BryanPuckettGH/growthpulse-app/docs/GrowthPulse Wiring Diagram.pdf

# GrowthPulse Node - Wiring

Heltec WiFi LoRa 32 V3 (HTIT-WB32LAF). Drawn to match the labels printed on your board.

## 1. Where the pins are - TOP row, USB-C on the right

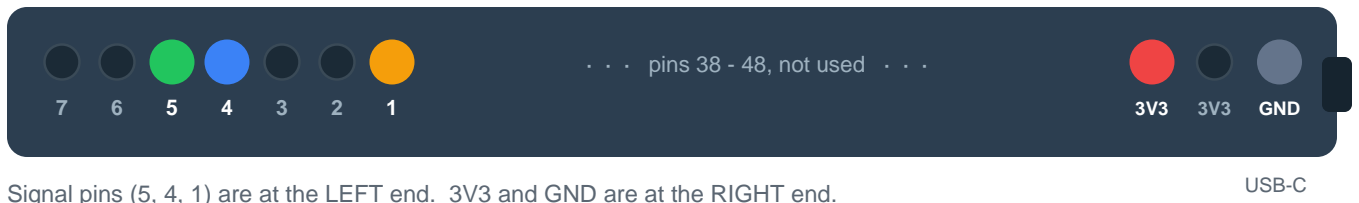
[picture p12: figure]
USB-C; · · · pins 38 - 48, not used · · ·; GND

Signal pins (5, 4, 1) are at the LEFT end. 3V3 and GND are at the RIGHT end.

2. Power the board: | USB-C, or the | 5V | and | GND | pins on the bottom row.

## 3. Connect each sensor (sensor pin -> board pin)

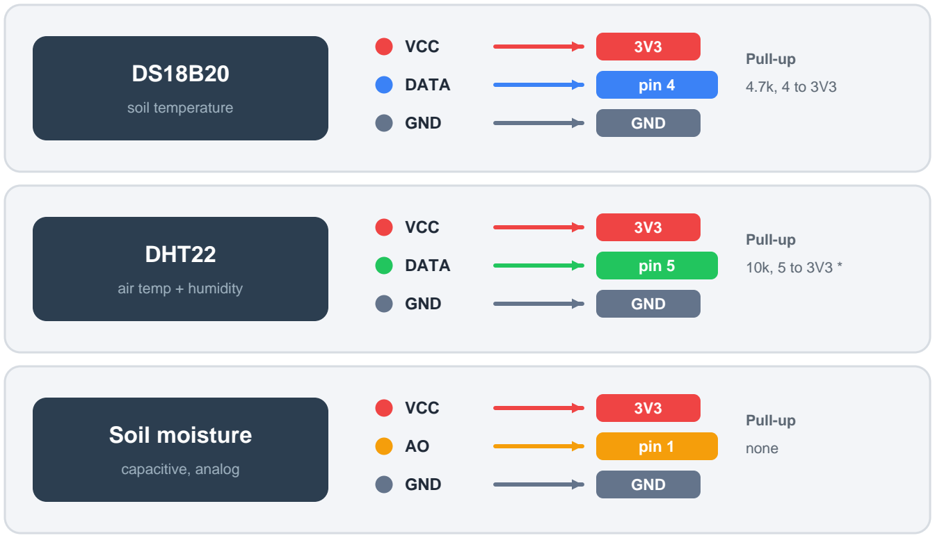
[picture p13: figure]
soil temperature; VCC; DATA; pin 4; GND; Pull-up; DHT22; air temp + humidity; pin 5; Soil moisture; capacitive, analog; pin 1; none

* the 3-pin DHT22 module already has its 10k resistor built in - just wire +, out, -.

Remember
All three sensors get VCC from 3V3 and GND from GND. Power sensors on 3V3 only - never 5V.
