BryanPuckettGH/growthpulse-app/CHANGELOG.md

# Changelog

All notable changes to GrowthPulse, the web app and the device firmware.

---

## Web App

### v2.26.0 - August 12, 2026
- LinkedIn is now reachable from the public site, which previously offered a visitor no way at all to make contact. The link sits under the signature in the welcome overlay, in The Project page header next to GitHub, and beside the commit-authorship line in the attribution section. All three read one `LINKEDIN_URL` constant in `WelcomeModal.jsx` and render nothing when it is empty, so the profile can never ship as a dead link.

### v2.25.0 - August 12, 2026
- The project video playlist is now embedded on The Project page: seven videos spanning the first concept pitch, the bench demos, and the final senior design presentation. Player is served from `youtube-nocookie.com` and lazy-loaded so it costs nothing until scrolled to, with a link out to the full playlist and a "Watch the build" button in the page header.
- The welcome overlay now opens on every load of the public site rather than once per browser session. It is the introduction to the project, so a refresh or a return visit should show it again; navigating between pages within the site still leaves it closed once dismissed.

### v2.24.0 - August 12, 2026
- The public site now introduces itself to the people who actually arrive on it. growthpulsecloud.com is linked from a resume, so a large share of first-time visitors are recruiters and engineers rather than customers, and the marketing copy alone never told them who built this or when. A welcome overlay (`WelcomeModal.jsx`) opens on arrival with a short note from the team lead, full Team 15 credits with each member's contribution, and two ways forward: browse the product site, or jump to the engineering write-up. Dismissal is remembered per browser session in `sessionStorage`, so moving between pages does not reopen it but a fresh visit does. It can be reopened any time from the footer.
- New "The Project" page (`ProjectPage.jsx`), a sixth entry in the marketing nav: the build by the numbers, the system layer by layer, a timeline, per-person attribution, and the six debugging problems worth talking about (the NE555 browning out on the 3.3V rail, the GPIO1 conflict with onboard battery sense, fitting flow and status into the 11-byte US915 DR0 payload, provisioning that minted orphan DevEUIs, Losant rejecting an entire state report over one undefined attribute, and `resets_join_nonces` being written to the Network Server instead of the Join Server).
- Marketing site caught up with the product. Everything shipped since v2.19.0 was invisible to a visitor: the site still sold a monitoring-only device with "4 sensors per node" and no mention anywhere of irrigation, the flow meter, water cost, leak detection, Google Home, or the iOS app. New "Watering" page covering timed runs, live flow confirmation, the self-closing dry-run cutoff, the leak alarm, meter-style cost accounting, and rain delay. The hero, the stats row, the home feature cards, the Features grid, and the FAQ all now describe a system that acts on what it measures instead of only reporting it.
- Footer gains a fourth column linking the project page, the team lead's note, and the GitHub repository, and a Watering link under Product.
- `.proj__numbers` grid children carry `min-width: 0` so the stats row cannot force horizontal overflow on a narrow window.

### v2.23.0 - July 7, 2026
- Water metering, from the new YF-S201 flow sensor (firmware 5.1). The Live view gains a Water card: live flow rate while watering, water used today / this week / this month with dollar costs, the current/last run's volume, and the lifetime total. Costs use a user-set rate in Settings ("$ per 1,000 gallons", straight off the utility bill), with a gallons/liters toggle that converts the rate when flipped.
- Smart watering warnings. If a watering run opens the valve and the sensor sees no water (empty reservoir, kinked line, dead pump), the node closes the valve itself and the app shows a "No water flow detected" banner; a `flowFault` alarm rule is on by default. A leak alarm trips when water flows for 30+ seconds while the valve is closed. Both are boolean fault alarms: the alarm card explains the condition instead of showing a threshold slider.
- The Watering card now shows live confirmation from the flow sensor during a run ("Flowing 1.9 L/min" or "Waiting for water to move...") so a dry run is visible the moment it happens.
- New `water-usage` function: usage per day computed meter-style by diffing the node's cumulative `waterTotalL` counter (MAX per bucket), which stays accurate across missed samples and handles counter resets. `device-state` passes the six new water fields through; `provision-device` defines them on new devices; `scripts/add-water-attributes.mjs` backfills devices provisioned before they existed (Losant drops state for undefined attributes, so run it once).
- The LoRaWAN uplink webhook now decodes both payload layouts by length: legacy 9-byte v1 and the new 11-byte v2 that carries flow, total, and the valve/fault/leak status bits (v2 drops the raw soil ADC to stay inside the US915 DR0 11-byte limit; moisture 0xFF now marks a disconnected probe).
- The device simulator publishes the water fields too, including a periodic simulated no-flow run, so the whole feature can be demoed without hardware.

### v2.22.2 - June 12, 2026
- Fixed `resets_join_nonces` never actually being set. It was being written to the Network Server, which rejects it as a forbidden field-mask path, so provisioning's attempt silently failed (and a new-device provision would have errored at that step). It is a Join Server setting; it now goes on the `js/` endpoint in both the create and reuse paths. With it set, a board joins LoRaWAN on the first try after a reflash instead of burning a minute of `-1116` DevNonce-catch-up retries.

### v2.22.1 - June 12, 2026
- Fixed the gateway QR scanner that sometimes would not open or would not scan. The scanner effect depended on its `onResult` callback, which the Devices view recreated on every render (and it re-renders every few seconds from the live-polling loop), so the camera was torn down and restarted constantly and never got a stable moment to decode. The effect now runs once on mount and reads the latest callback through a ref. Also added `autoPlay` to the video and a metadata-load play retry so frames flow reliably (notably on iOS Safari, where `play()` can be rejected outside the original tap).

### v2.22.0 - June 11, 2026
- Fixed the root cause of LoRaWAN data never reaching the app: Losant rejects an entire state report that includes an attribute the device doesn't define, so devices created before the `loraRssi`/`loraSnr`/`transport` attributes existed silently dropped every LoRaWAN uplink (Wi-Fi state, which has no LoRa fields, still worked). The repeated 502s caused The Things Stack to auto-deactivate the uplink webhook. `provision-device` now syncs the full attribute schema on every provision (not just on create), so existing devices self-heal on their next check-in.
- `lorawan-uplink` now logs the exact outcome of each delivery (resolved device, 200/401/404/422/502 + Losant's rejection detail) to make webhook failures diagnosable in the Netlify function log.

### v2.21.0 - June 10, 2026
- LoRaWAN provisioning is now idempotent: one TTS device per board, reused on every switch, instead of minting a new DevEUI each time. The old behavior spawned an orphan TTS device on each Wi-Fi→LoRaWAN switch, so downlinks (the Wi-Fi switch-back) could land on a device the node never joined and fail with `no_device_session`. Provisioning now looks the board up by its Losant id and re-pushes its stored keys if it already has an identity. New migration `docs/growthpulse-lorawan-routes-schema-v2.sql` adds an `app_key` column and a uniqueness constraint on the board id (clears v1 orphan rows).
- The Wi-Fi switch-back downlink now targets that single stable device, so it actually reaches the node.
- Provisioning surfaces a real error if the route fails to store (previously a Supabase rejection was swallowed, leaving the uplink webhook unable to map the board).

### v2.20.0 - June 10, 2026
- Round-trip transport switching now works both ways and shows the truth. The uplink webhook decodes the node's 9-byte payload itself, so an auto-provisioned LoRaWAN device no longer needs a per-device payload formatter set in The Things Stack; its readings (and LoRa RSSI/SNR + battery) land in the app immediately. A device on LoRaWAN now actually reads "LoRaWAN" on its card.
- Switch a node back to Wi-Fi from the app: the new `lorawan-switch-wifi` function enqueues a downlink the node applies on its next check-in, then it reboots into Wi-Fi (a LoRaWAN node is off the cloud's direct reach, so a downlink is the only way down to it).
- The transport tag is now authoritative: both firmware paths stamp `transport` on every report, so a stale `loraRssi`/`wifiRssi` left in the cloud composite right after a switch can no longer make the card show the wrong link. New env var for the switch path: reuses `TTS_API_KEY`, `TTS_APP_ID`, `TTS_CLUSTER`.

### v2.19.0 - June 10, 2026
- Automated LoRaWAN provisioning, the LoRaWAN twin of Wi-Fi self-provisioning. Switching a device to LoRaWAN in the app now sets the board up automatically: the new `provision-lorawan` function generates fresh OTAA keys, creates a unique end-device on The Things Stack (the 4-call IS/JS/NS/AS API), routes it to the board's existing Losant identity, and pushes the keys to the board (online over Wi-Fi), which reboots into LoRaWAN and joins. No console, no hand-pasted keys. Each switch mints its own DevEUI, so a teammate's board is flash-and-go on LoRaWAN.
- Dynamic routing: the uplink webhook now resolves the target Losant device from the Supabase `lorawan_devices` table (written at provision time) instead of a hand-edited env map. New migration `docs/growthpulse-lorawan-routes-schema.sql`.
- Combined firmware gained a `provisionLoRa` command (receives pushed keys, saves to flash, switches to LoRaWAN). Setup + env vars in `docs/GrowthPulse LoRaWAN Auto-Provision Setup.md` (needs `TTS_API_KEY`, `TTS_APP_ID`).

### v2.18.0 - June 10, 2026
- Auto-register gateways on The Things Stack: adding or scanning a gateway in the app now registers it on your TTS network and ties it to the account automatically, the customer never touches The Things Stack. New `register-gateway` serverless function (validates the signed-in user, creates the gateway via the TTS API). Setup in `docs/GrowthPulse Gateway Auto-Register Setup.md` (needs `TTS_API_KEY`, `TTS_USER_ID` env vars). The gateway hardware still ships pre-pointed at your TTS server.
- New combined node firmware (`firmware/GP_Combined`): one identical image runs either Wi-Fi or LoRaWAN, chosen by a saved flag. Wi-Fi units self-provision and do the saved-Wi-Fi-then-hotspot flow; LoRaWAN units load OTAA keys from flash and join any gateway. The OLED shows the live path and signal (Wi-Fi dBm or LoRa RSSI). Switch modes from the setup portal, the app (`setMode` command), or a downlink. No per-board secrets in the image.

### v2.17.0 - June 9, 2026
- LoRaWAN is now real, not "in development." The app shows a node's true link from its telemetry: a Wi-Fi build reports Wi-Fi, a LoRaWAN build (that joins through your gateway) shows as LoRaWAN. Removed the interim code that forced every node to display Wi-Fi, and removed the "still in development" notes.
- Live LoRa signal: the connection badge now shows real link quality, Wi-Fi RSSI for Wi-Fi nodes, and RSSI plus SNR for LoRaWAN nodes, on the dashboard and device cards. The `device-state` and uplink pipeline now carry `loraRssi`, `loraSnr`, and the transport tag end to end.
- Gateways follow your account. LoRaWAN gateways are now saved to your Supabase account instead of only the browser, so they persist across logins and devices (requires the one-line `docs/growthpulse-gateways-schema.sql` migration). Same fix class as plans persisting.
- Honest flows: onboarding no longer assumes Wi-Fi (you pick Wi-Fi or a LoRaWAN gateway when claiming), and switching a device to LoRaWAN now explains it joins through the gateway and reports every few minutes.

### v2.16.0 - June 9, 2026
- Your plan now sticks. The subscription tier (Free / Plus / Pro) is saved on your account instead of only in the browser, so it follows you across logins and devices. Before, a fresh login defaulted back to Free and you had to "upgrade" again every time.

### v2.15.0 - June 5, 2026
- Device cards now respect the disconnected-sensor check for moisture: a card whose probe isn't connected shows "—" / "no probe" instead of a misleading 100%.

### v2.14.0 - June 5, 2026
- Device cards now show each unit's pairing code (e.g. #B0713A), so you can always tell units apart even if you forget what you named them.

### v2.13.0 - June 5, 2026
- The plant name in the top bar is now a real dropdown: tap it to switch plants in place (with photos) without leaving the current view. Before, it jumped you to the Devices tab and you had to navigate back to Live.

### v2.12.2 - June 5, 2026
- A device that's still checking in now shows "Connecting…" for up to 15 seconds instead of briefly flashing "Offline" before its first reading lands. Matches the few seconds a node needs to report after the page loads.

### v2.12.1 - June 5, 2026
- The connection badge now reflects reality without any extra setup: a real node that's reporting data shows Wi-Fi (its actual link), even if LoRaWAN was selected. The transport picker explains that LoRaWAN node firmware is still in development and the node uses Wi-Fi today.

### v2.12.0 - June 5, 2026
- First load no longer says "Offline". A claimed device that hasn't reported yet shows "Connecting…" (amber) until the first reading arrives, and the app polls immediately instead of waiting a full refresh cycle, so customers aren't scared into refreshing.
- Honest connection: the dashboard and device cards now show how a node is ACTUALLY connected (Wi-Fi, with signal) based on what the node reports, instead of a transport label you picked. Needs firmware v2.3 and a `wifiRssi` number attribute in Losant.
- Device photo: crop the picture after taking/choosing it (square, pan and zoom).

### v2.11.0 - June 5, 2026
- Device photos: add a picture to any plant/node (camera or upload). It shows on the device cards, the dashboard, and follows your account across browsers. Requires the one-line `docs/growthpulse-devices-photo.sql` migration.
- Add-a-gateway now uses the Gateway EUI (the 16-hex ID on the label's EUI line) instead of a generic code, that's the identifier a LoRaWAN network server needs. You can scan the label's QR (the app pulls the EUI out of the bundled MAC/EUI/serial payload) or type it.

### v2.10.0 - June 5, 2026
- Location is now fully optional. The app never asks for your device/GPS location and never shows a fake default city. A plant's location is only used by weather features, and you add it yourself (city or ZIP) when you want them.
- New **Rain delay** (Pro): skip automatic watering when rain is in the local forecast. Because it needs the forecast where the plant lives, turning it on asks for that plant's location and explains why; the switch names the node that still needs one.
- Weather card invites you to add a location instead of guessing one.
- Manuals: User + Engineering manuals updated for everything since the last revision (full report export, server-side PDF, cloud device ownership, location/rain delay).

### v2.9.2 - June 5, 2026
- The app no longer asks for your device location. Weather follows each plant's own home location; plants without one show a clearly-marked default city until you set it.

### v2.9.1 - June 5, 2026
- Report download now shows a clear loading screen with a spinner and step ("Gathering data…", "Rendering your PDF…") so it's obvious the work is in progress. The sheet won't close mid-render and the buttons can't be double-fired.

### v2.9.0 - June 5, 2026
- Server-side PDF rendering: the Download button now renders the report through headless Chrome in the cloud, producing a true vector PDF with crisp, selectable text.
- Automatic fallback: if the server is unavailable, slow, or the account is in demo mode, it silently falls back to the in-browser renderer, so the download always works.
- The render endpoint requires a signed-in session, so it can't be abused as an open PDF service.

### v2.8.2 - June 5, 2026
- Downloaded PDFs are much sharper: higher render resolution and lossless image encoding.
- Fixed app styles leaking into the downloaded report (the logo rendered centered).
- Report stats no longer count a disconnected air sensor's zero readings (the "Min 0°F" artifact).

### v2.8.1 - June 5, 2026
- Report sheet now has two delivery buttons: "Download PDF" saves a real .pdf file directly, "Print report" opens the print dialog (paper, or sharpest save-as-PDF output).

### v2.8.0 - June 5, 2026
- Full plant report: the Settings download is now a complete PDF report with per-sensor history graphs (ideal-range shading, min/avg/max, offline gaps) and a chronological activity timeline.
- Report options: pick the time period (24h / 7 days / 30 days / everything / custom dates), which plants, and which sensors to include.
- New `device-history` cloud function pulls the full sensor history from the device cloud, so reports cover the entire time a device has been connected (auto-averaged to stay readable).
- Removed the JSON export link from Settings.

### v2.7.0 - June 5, 2026
- Cloud device ownership: claimed plants now live in the account, not the browser. Sign in anywhere and your plants follow; one-time automatic migration of existing claims.
- A pairing code can only be claimed by one account at a time.
- Factory reset is now authorized server-side: only the device's owner can send it.
- Branded PDF account export replaced the plain JSON download.
- Landing page v2: sub-pages (Features, Farm Kit, Pricing, FAQ), new button system, polished hero.

### v2.6.0 - June 5, 2026
- Offline detection: devices flip to Offline after 45s of silence (15 min for LoRaWAN), with "last reading X ago" on the dashboard and device cards. Stale data can no longer appear live.
- Forgot password: email reset link with a branded set-new-password screen.
- Download my data: one-click JSON export of devices, alarms, journals, gateways, and settings.
- Version stamp in Settings (version + build date).
- History no longer records duplicate readings while a device is offline.

### v2.5.0 - June 5, 2026
- Documentation shipped into the repo: User Manual, Engineering Manual, Wiring Guide and Diagram, Product Roadmap, Deployment Model (PDF + markdown).
- Sanitized firmware and bench diagnostic sketches added under `firmware/`.
- Full README rewrite: architecture, setup, env vars, security model.

### v2.4.0 - June 5, 2026
- Disconnected-sensor detection: probes that are unplugged show "not connected" with fix-it hints instead of garbage values; health score counts only live sensors.
- Power status: AC/battery badges with charging state and low-battery warnings.
- Device groups (Greenhouse, Backyard, ...) with grouped Devices view.
- Shareable plant report: branded printable PDF with readings, stats, weather, and journal.
- Refresh-rate options became LoRaWAN-aware, with battery-drain guidance.
- Fixed device card text overflow on narrow screens.

### v2.3.0 - June 4, 2026
- Signup upgraded: first/last name, confirm password, grower type; the app greets users by name.
- Per-plant home location: weather and rain alerts follow the plant, not the owner's phone.
- Device management: rename, edit location, switch connection type, delete with full data purge.
- Factory reset for resale: remote Wi-Fi wipe via cloud command, with data-loss disclaimer.
- Connection choice at setup (Wi-Fi or LoRaWAN gateway); gateway management section; Ethernet retired.
- Desktop fix: onboarding screen no longer renders inside the sidebar column.

### v2.2.0 - June 4, 2026
- Installable app (PWA): Add to Home Screen with real icons, full-screen mode, notch/safe-area support.
- Form fields inherit the app font (fixed "shifted" text in inputs).

### v2.1.0 - June 3, 2026
- Pairing codes validated against the device registry (Supabase); junk codes rejected.
- Honest device states: claimed devices show "waiting for first reading" until real data arrives.

### v2.0.0 - June 3, 2026
- Real accounts (Supabase auth) with per-account data isolation.
- Demo mode for prospects, fully separated from real data.
- Live cloud readings through the secure `device-state` serverless connector.
- Claim-a-device onboarding for new accounts.

### v1.2.0 - June 3, 2026
- Losant cloud integration: device, access keys, telemetry simulator.
- Real email/SMS alert workflows (fire even with the app closed).

### v1.1.0 - June 2, 2026
- Plant profile catalog with species-specific ideal ranges.
- Weather rain gauge with rain-aware watering suggestions.
- Growth journal with photos; irrigation control card; subscription tiers; dark mode; smarter alarms with auto-set; device editing; richer history charts with ideal bands.

### v1.0.0 - June 1, 2026
- Initial app: live dashboard with health score, history charts, alarm rules, device list, full design system, simulated data.

---

## Device Firmware (GP_Combined, Wi-Fi + LoRaWAN)

One identical image that boots into either Wi-Fi or LoRaWAN based on a saved flag in flash (NVS). No per-board secrets live in the image. This is the firmware that ships on production units. (v5.x lives in `firmware/GP_Final`.)

### v5.1 - July 7, 2026
- Water flow metering with the YF-S201 hall-effect sensor on GPIO47 (450 pulses/L, counted by interrupt). Reports live flow (L/min), the current/last run's liters, and a lifetime total that persists in NVS with wear-friendly writes (every 2 L and at the end of each run). Wiring note: the sensor runs on 5V and outputs 5V pulses; the signal must pass through a 10k/20k divider because the ESP32-S3 is not 5V tolerant (see the Water Sensor Guide).
- No-flow watchdog: if the valve is open for 8 seconds and the line is still dry, the node closes the valve itself, shows NO WATER FLOW on the OLED, and latches a `flowFault` that reports to the app until a later run actually sees water. Protects the pump and stops phantom watering.
- Leak watchdog: sustained flow (30 s) while the valve is closed raises `leakDetected`; clears itself when the flow stops.
- A fourth OLED page (WATER) rotates in: live flow, last run, lifetime total, and any active fault.
- LoRaWAN uplink grows to the 11-byte v2 layout carrying flow, total, and valve/fault/leak status bits, still within the US915 DR0 application-payload limit. The webhook decodes v1 and v2 by length, so mixed fleets keep working.

### v4.3 - June 12, 2026
- The OLED pairing screen now shows the running firmware version (small, just under the connection type), so the build on a unit is visible at a glance without opening the serial monitor.

### v4.2 - June 11, 2026
- Switch-to-Wi-Fi from the app is responsive again. The LoRaWAN uplink interval was lowered from 15 minutes to 60 seconds for bench and demo use, because a class-A node can only receive a downlink (such as the switch-to-Wi-Fi command) during the short window right after it uplinks. A 15-minute interval meant a switch could take up to 15 minutes to land. The 15-minute value is the right production setting for The Things Network fair-use airtime, so the constant is documented for raising before shipping.
- Removed the 20-second post-join guard on the switch-to-Wi-Fi downlink. The backend now clears any stale queued downlink when it provisions LoRaWAN, so any 0x00 the node receives is a real, deliberate switch and is acted on immediately. The guard had been suppressing legitimate switches that arrived shortly after a join.

### v4.1 - June 11, 2026
- Faster, more reliable joins after a reflash. The OTAA join retry interval dropped from 30 seconds to 10 seconds, so the DevNonce catch-up that follows an NVS wipe resolves in a fraction of the time. The backend also sets `resets_join_nonces` on each device so The Things Stack accepts a reset DevNonce and the node joins on the first try.
- The PRG button is now tiered and safe. A 3-second hold gracefully returns a stuck LoRaWAN unit to Wi-Fi while keeping its saved Wi-Fi credentials. A 10-second hold performs the full factory reset (wipe Wi-Fi, reopen setup) for handing a unit to a new owner. The OLED shows which action is about to fire while the button is held. Previously a 3-second hold wiped Wi-Fi outright.
- Anti-bounce guard against stale cloud commands. The firmware ignores `provisionLoRa`, `factoryReset`, and `setMode` commands that arrive in the first 12 seconds after connecting to the cloud, because a command delivered the instant a device reconnects is a stale one the broker is redelivering. This stopped a loop that bounced a unit between Wi-Fi and LoRaWAN and could wipe its Wi-Fi on every connect.
- Wi-Fi telemetry now stamps `transport: "wifi"` on every report so the app's link display can never be fooled by a stale LoRaWAN signal value left in the cloud composite state after a switch.
- The OTAA join path now actually joins. `beginOTAA` only sets the keys; `activateOTAA` performs the join. The combined image had been calling only the first, which set keys but never joined, producing a session-not-active error (-1101) on the first uplink. Added the `activateOTAA` retry loop and the 8-argument `sendReceive` form that matches the proven standalone LoRaWAN sketch.

### v4.0 - June 9 to 10, 2026
- First combined image. A saved mode flag in NVS selects the boot path: Wi-Fi (self-provision over HTTPS, then stream to Losant over MQTT) or LoRaWAN (load OTAA keys from NVS, join any gateway, uplink a 9-byte payload). The mode can be set from the setup portal, from the app via a `setMode` command, or by a downlink.
- `provisionLoRa` command. The backend pushes OTAA keys (JoinEUI, DevEUI, AppKey) to a Wi-Fi-connected board, which saves them to NVS and reboots into LoRaWAN. This is the firmware half of automated LoRaWAN provisioning.
- A nice OLED user interface for both modes: the rotating status pages show the pairing code, the live connection (Wi-Fi dBm or LoRa RSSI and SNR), and the live sensor readings.
- Persists LoRaWAN join nonces across reboots so DevNonce keeps incrementing, and brings up the SX1262 with the V3-specific TCXO voltage and DIO2-as-RF-switch settings.

---

## Device Firmware (GP_Provisioning)

### v3.11 - June 9, 2026 (GP_Node)
- Optional true USB-vs-battery detection. Add a 100k/100k divider from the board's 5V pin to GND with the midpoint on GPIO7, then set `USE_VBUS_SENSE` to 1 and reflash. The firmware then reads a real "plugged in" signal (midpoint ~2.5V on USB, 0V on battery) instead of guessing from voltage: plugged shows AC/Charging, on battery shows the real percent, and the no-battery-on-USB phantom is gone. Default is off, so boards without the wire keep the voltage-only behavior unchanged.

### v3.10 - June 9, 2026 (GP_Node)
- No-battery-on-USB now reads as AC, not a phantom percent. With no battery installed, the charge chip holds the sense line near a full pack's voltage (the board has no battery-detect pin). When that line sits pinned at the top and is no longer rising, the unit now reports AC power instead of a misleading climbing percent. Running on a real battery is unaffected; a pack mid-charge still shows "Charging".
- Sleep label: the power-off screen now reads "Sleeping" (it is deep sleep, ~microamps, not a true zero-power off, which the board can't do without a hardware switch).

### v3.9 - June 9, 2026 (GP_Node)
- Power button: the unit can now be turned off without unplugging. Double-tap the PRG button and it drops into deep sleep (~microamps, screen off, no telemetry, months on a charge). A single PRG press wakes it back up (RESET works too); it reboots, reloads its saved Wi-Fi and cloud identity, and reconnects on its own. Waking from sleep no longer triggers the boot-time Wi-Fi wipe.

### v3.8 - June 9, 2026 (GP_Node)
- Battery percent no longer jumps when you plug in. A charger inflates the pack's measured voltage the instant it connects (a 44% pack reads ~65%), so the shown percent now creeps at most 1% per reading: it only rises while charging and eases back toward the true level on battery. No more 44 to 65 leap.

### v3.7 - June 9, 2026 (GP_Node)
- Battery reading fixed: this board's battery-sense control pin (GPIO37) is inverted from the documented Heltec wiring. It now drives the divider with the correct polarity and averages 16 samples, so the OLED and app show a real percent instead of "AC/USB" 0%.
- Charging indicator: the node infers charge state from the battery voltage (the V3 exposes no charge-status pin) and reports it. The OLED shows "Charging +" and the app's power badge shows a charging bolt while the pack is taking current or sitting at the charger's top voltage.

### v3.0 - June 5, 2026 (GP_Node, self-provisioning)
- New `GP_Node` firmware: one identical image for every board, NO per-board secrets. On first boot a board registers itself (sends its pairing code + a shared token to the `provision-device` endpoint), receives its own Losant device + access key, and saves them to flash. Flash any number of boards; each appears in the app as its own plant. This is the "mail a customer a board" path. The previous `GP_Provisioning` v2.3 (hard-coded identity) remains for reference.

### v2.3 - June 5, 2026
- Boot sensor self-test now holds on screen for 10 seconds so it's readable.
- Reports Wi-Fi signal strength (`wifiRssi`) in telemetry so the app can show the node's real connection instead of a user-set label.

### v2.2 - June 5, 2026
- Rotating status screen: the OLED cycles every ~5 seconds through the pairing code + connection state, a connection page (link type, Wi-Fi signal in dBm, IP address), and live sensor readings. Disconnected probes read "--" honestly.
- The screen now states the active link ("Wi-Fi"); a future LoRaWAN build flips `LINK_LABEL` so the unit always shows the truth of how it's connected.

### v2.1 - June 5, 2026
- Boot self-test: POST-style checklist on the OLED (soil temp / air / moisture) before going online.
- Hardware watchdog: automatic reboot on firmware hang, portal-aware so setup is never interrupted.
- OLED burn-in protection: screen dims after 5 idle minutes, any PRG tap wakes it.

### v2.0 - June 5, 2026
- Remote factory reset: the app sends a cloud command and the unit wipes its own Wi-Fi and reboots into setup mode for a new owner.

### v1.6 - June 4, 2026
- Soil moisture moved to GPIO2 (GPIO1 conflicts with the board's battery-sense circuit).
- Soil sensor powered from 5V (NE555 oscillator requires >4V; resolves frozen 100% readings).
- Raw soil ADC added to telemetry and the serial line for field calibration.

### v1.5 - June 4, 2026
- Pairing code displayed large on the built-in OLED (no Serial Monitor needed).
- PRG reset paths: hold at power-on, or hold 3 seconds any time, to wipe Wi-Fi and reopen setup.
- Captive-portal fixes: faster phone joins (no background scan-hopping, no modem sleep), setup window extended to 10 minutes.

### v1.0 - June 3, 2026
- Provisioning firmware: branded captive-portal Wi-Fi setup (logo, welcome page), chip-ID pairing code, Losant cloud streaming with auto-reconnect.

### v0.9 - late May 2026
- Team baseline sketch: sensor reads with hardcoded Wi-Fi credentials, serial output (original team repository).
