BryanPuckettGH/growthpulse-app/(commit log)

2026-06-03 Add subscription tiers with demo buy-and-unlock flow
2026-06-03 Fix History, smarter per-device alarms, device editing, growth journal
2026-06-03 Alarm rule sensor picker
2026-06-03 Add real device data connector, claim flow, demo mode
2026-06-03 Real device connector, claim flow, demo mode, accounts
2026-06-03 Claim-code flow with device registry
2026-06-03 Signup profiles, per-plant home weather, device delete and factory reset
2026-06-04 Refresh rates aware of LoRaWAN, battery guidance, transport education
2026-06-04 Detect disconnected sensors, show honest status and fix-it hints
2026-06-05 Power status, device groups, shareable plant report
2026-06-05 Fix device card overflow, add low battery warnings
2026-06-05 Add manuals, wiring docs, sanitized firmware, and diagnostics for team sharing
2026-06-05 Add PDF versions of wiring guide, roadmap, and deployment model
2026-06-05 v2.6.0: marketing landing page, changelog, version history
2026-06-05 v2.7.0: cloud device ownership
2026-06-05 v2.7.0: cloud device ownership, landing page v2 with sub-pages
2026-06-05 v2.8.1: direct PDF download + print button in report sheet
2026-06-05 v2.8.2: sharper PDF download, style isolation, drop disconnected-sensor zeros
2026-06-07 v2.11.0: device photos, gateway EUI + QR scan; firmware v2.2 rotating screen
2026-06-08 Self-provisioning: provision-device function + GP_Node firmware
2026-06-08 v2.13.0: in-place device switcher; unique pairing code fix
    [GP_Provisioning.ino]
2026-06-09 v2.14.0: pairing code on device cards
2026-06-09 v2.15.0: honest moisture on device cards; firmware v3.6
2026-06-10 App v2.16.0: persist plan on account; firmware v3.11 (battery %, charging, power button, optional USB sense)
2026-06-10 App v2.19.0: automated LoRaWAN provisioning (TTS device + keys per board)
2026-06-11 lorawan provision: device registration to eu1 Identity Server, NS/JS/AS to cluster
2026-06-11 v2.20.0: decode LoRaWAN uplinks server-side, switch-back-to-WiFi downlink, authoritative transport tag
2026-06-11 Fix WiFi switch gating + surface route-store failures in provisioning
2026-06-11 v2.21.0: idempotent LoRaWAN provisioning (one TTS device per board)
2026-06-11 v2.22.0: sync Losant attribute schema on provision (fixes LoRaWAN state 502)
    [GP_Combined.ino]
2026-06-27 Backend: support setValve (open/close) in device-command
2026-06-27 Sync repo firmware with flashed build: valve control + baked token; update teammate checklist
2026-06-27 Valve: wire web app pump button to setValve; sync firmware; backend setValve
2026-07-02 Add Google Home integration: OAuth endpoints, fulfillment webhook, timed valve firmware
2026-07-02 Add air temp/humidity sensor device to Google Home
2026-07-07 v2.23.0 + fw v5.1: YF-S201 water metering
    - Firmware: flow sensor on GPIO47, no-flow watchdog (auto-close + flowFault),
    leak detection, NVS-persisted lifetime total, OLED WATER page, 11-byte
    LoRaWAN v2 payload
    - App: Water card (live flow, daily/weekly/monthly usage + cost), water
    price/units in Settings, default-on no-flow and leak alarms, live flow
    readout in the Watering card
    - Backend: water-usage function (meter-style counter diff), device-state
    water fields, v1/v2 uplink decoding, water attrs on provision
    - scripts/add-water-attributes.mjs backfills existing Losant devices
    [GP_Final.ino]
2026-07-09 Added localized bench test code to test solenoid valve functionality
2026-07-09 move the correct directory within hardware_validation
    [test_irrigation.ino]
